armbian/mpads/README.md

## MPADS
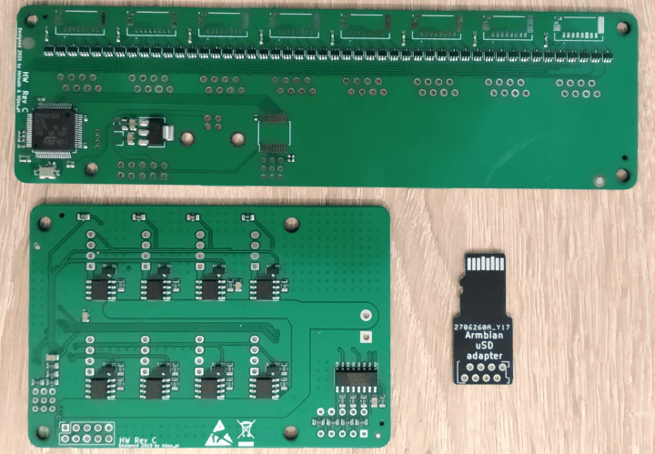
[picture p1: images/mpadsv3.jpg]
Assembled device
<h3 align=center><p><p>Multiple Power And Data Switch</h3>

## Serial MUX board revC
KiCAD 5.99 (new schematic file format)
- decoupling added
- some tweaking of LED control line selection
