armbian/mpads/images/mpads.jpg

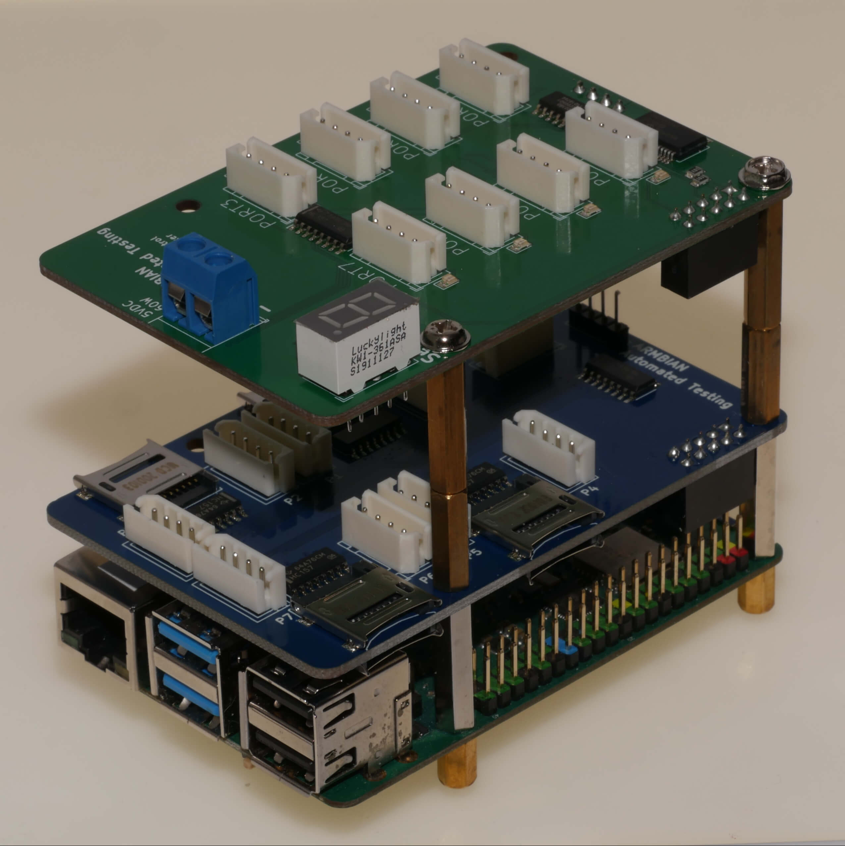
images/mpads.jpg
