armbian/mpads/sd-card-adapter/sd-adapter.png

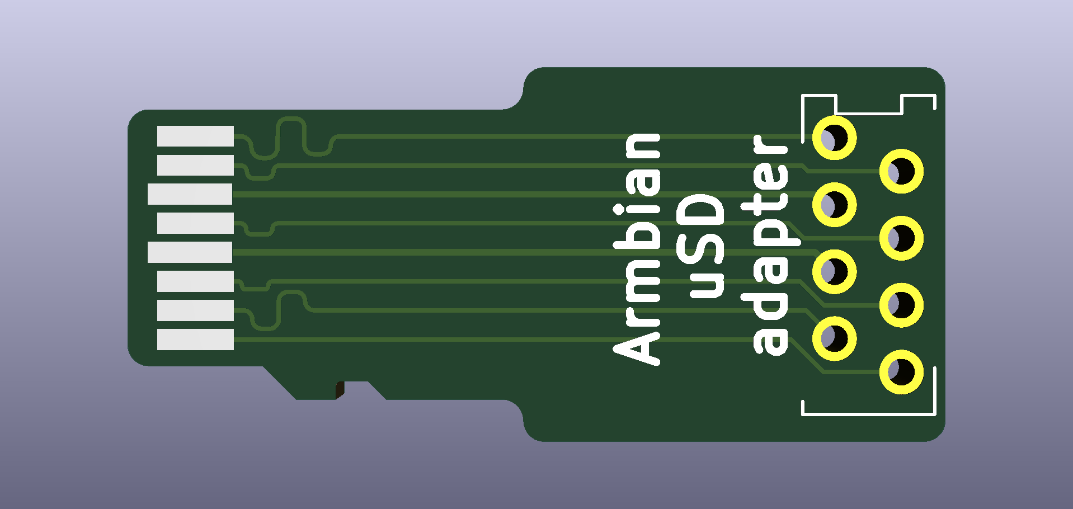
sd-card-adapter/sd-adapter.png
