armbian/mpads/sd-card-mux/ASSEMBLY/sd-card-mux-a.png

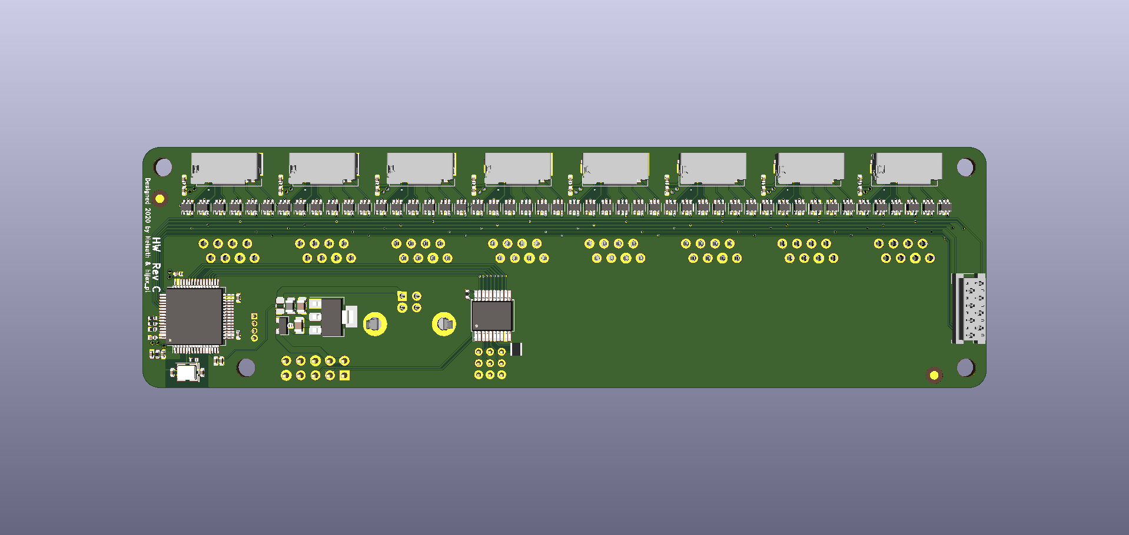
sd-card-mux/ASSEMBLY/sd-card-mux-a.png
