armbian/mpads/sd-card-mux/ASSEMBLY/sd-card-mux-b.png

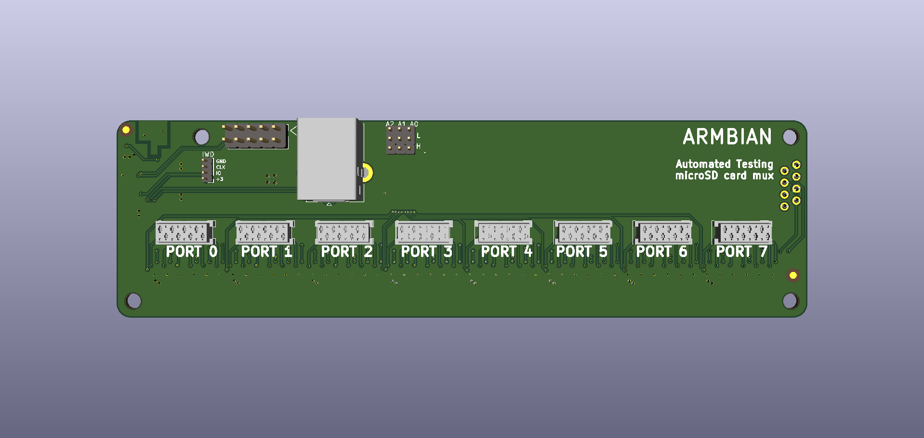
sd-card-mux/ASSEMBLY/sd-card-mux-b.png
