armbian/mpads/sd-card-mux/ASSEMBLY/sd-card-mux.pdf

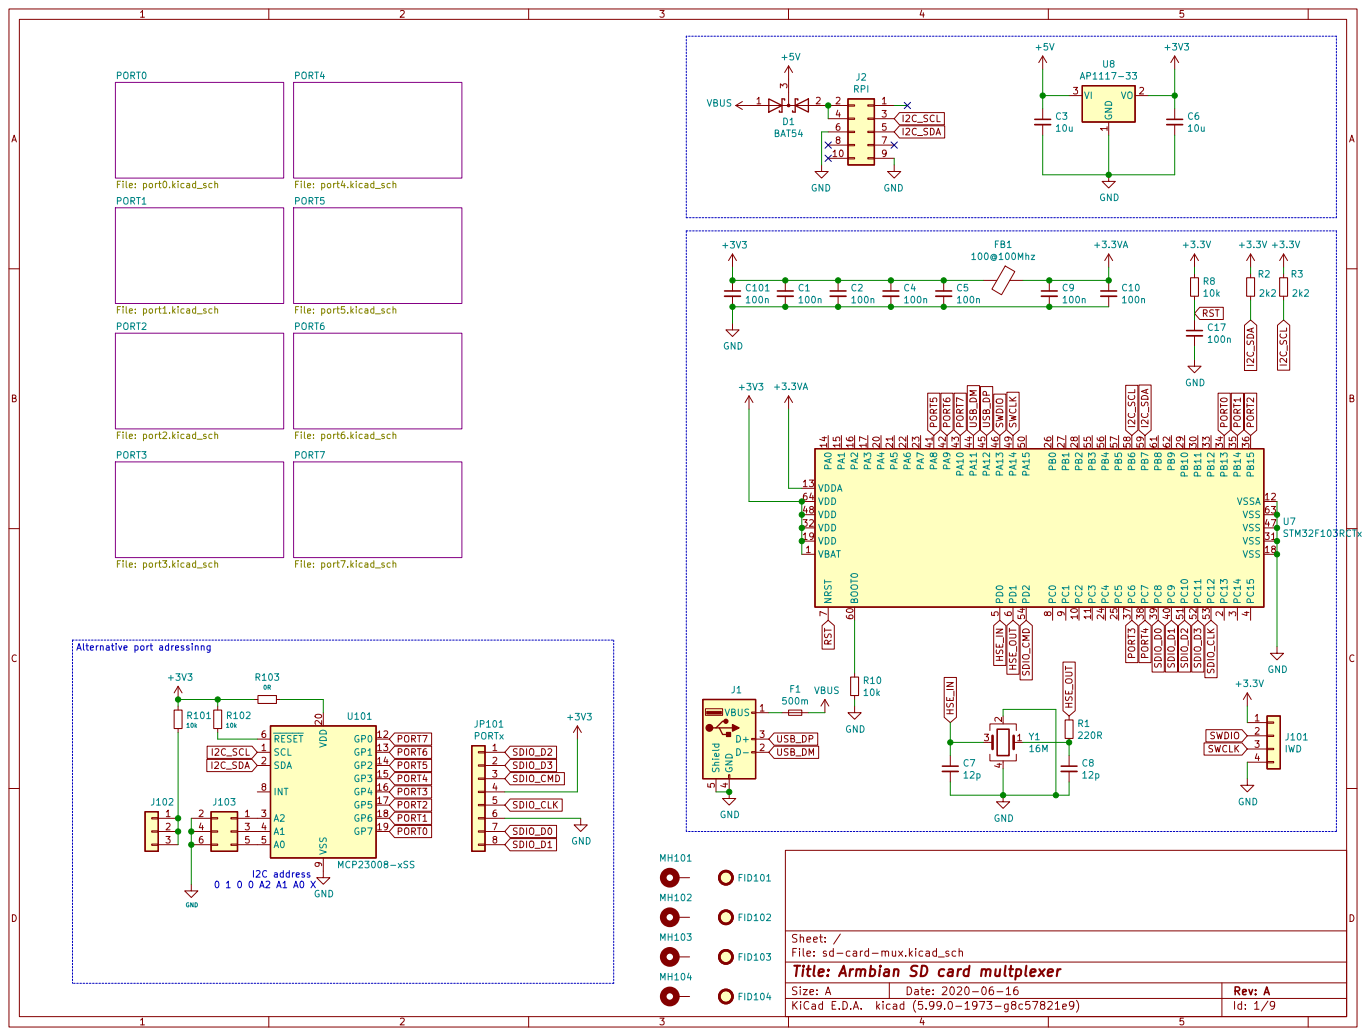
[picture p9: page 1]

6 PD2 54 VBAT 1 VDD 19 VDD 32 VDD 48 VDD 64 VDDA 13 VSS 18 VSS 31 VSS 47 VSS 63 VSSA 12 U7STM32F103RCTx +3V3 +3.3VA

File: sd-card-mux.kicad_sch Sheet: /
Id: 1/9 Title: Armbian SD card multplexer

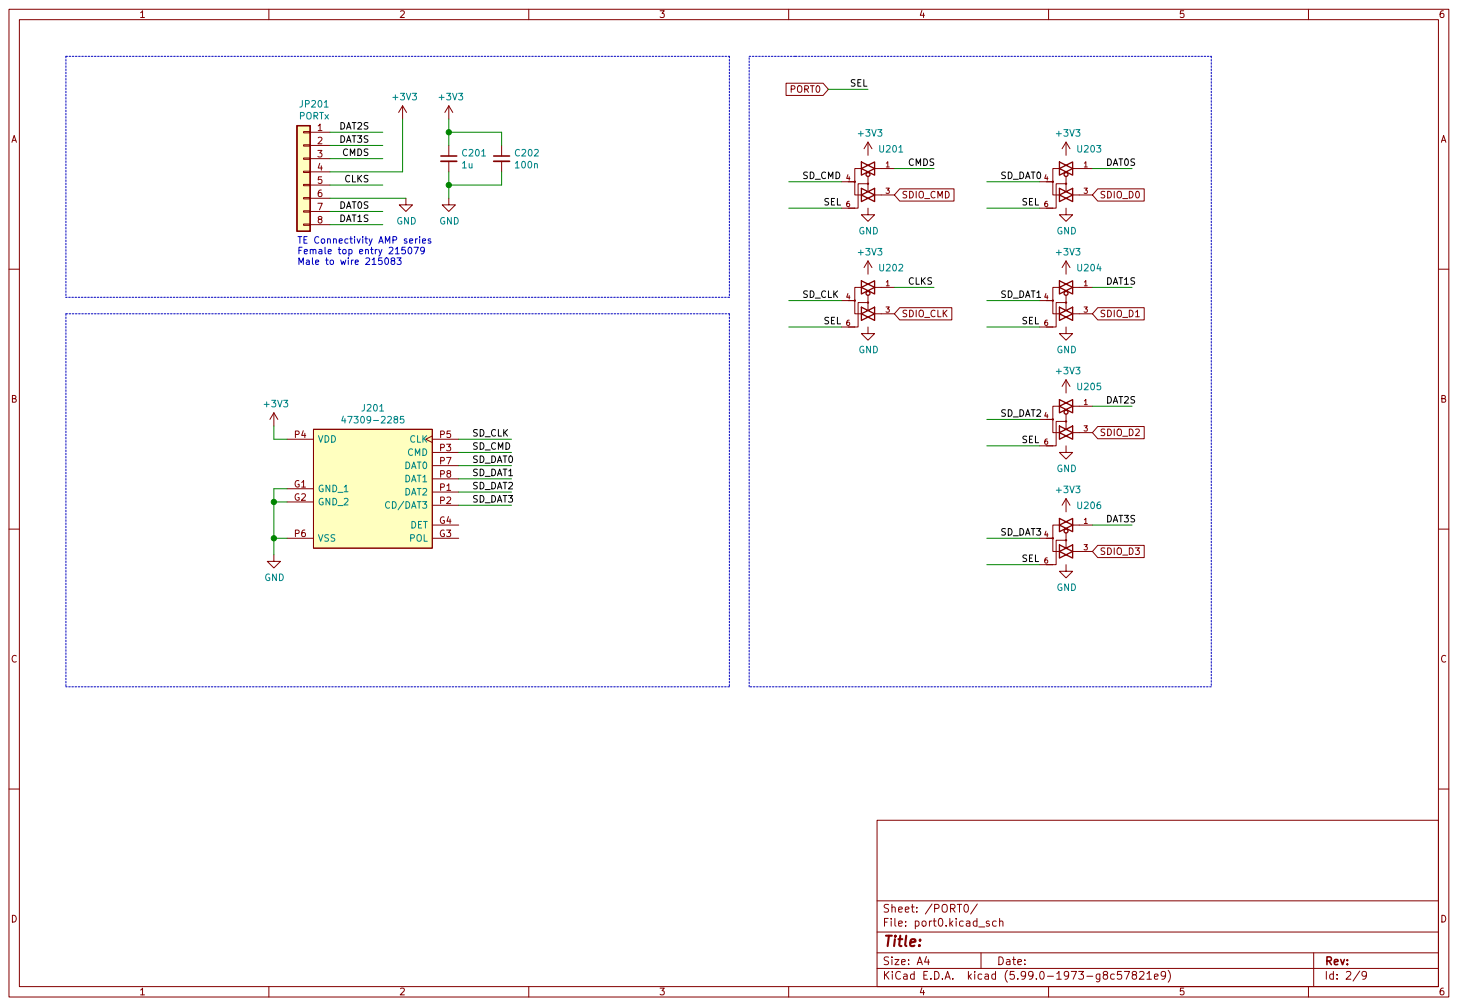
[picture p10: page 2]

TE Connectivity AMP series
Female top entry 215079 Male to wire 215083

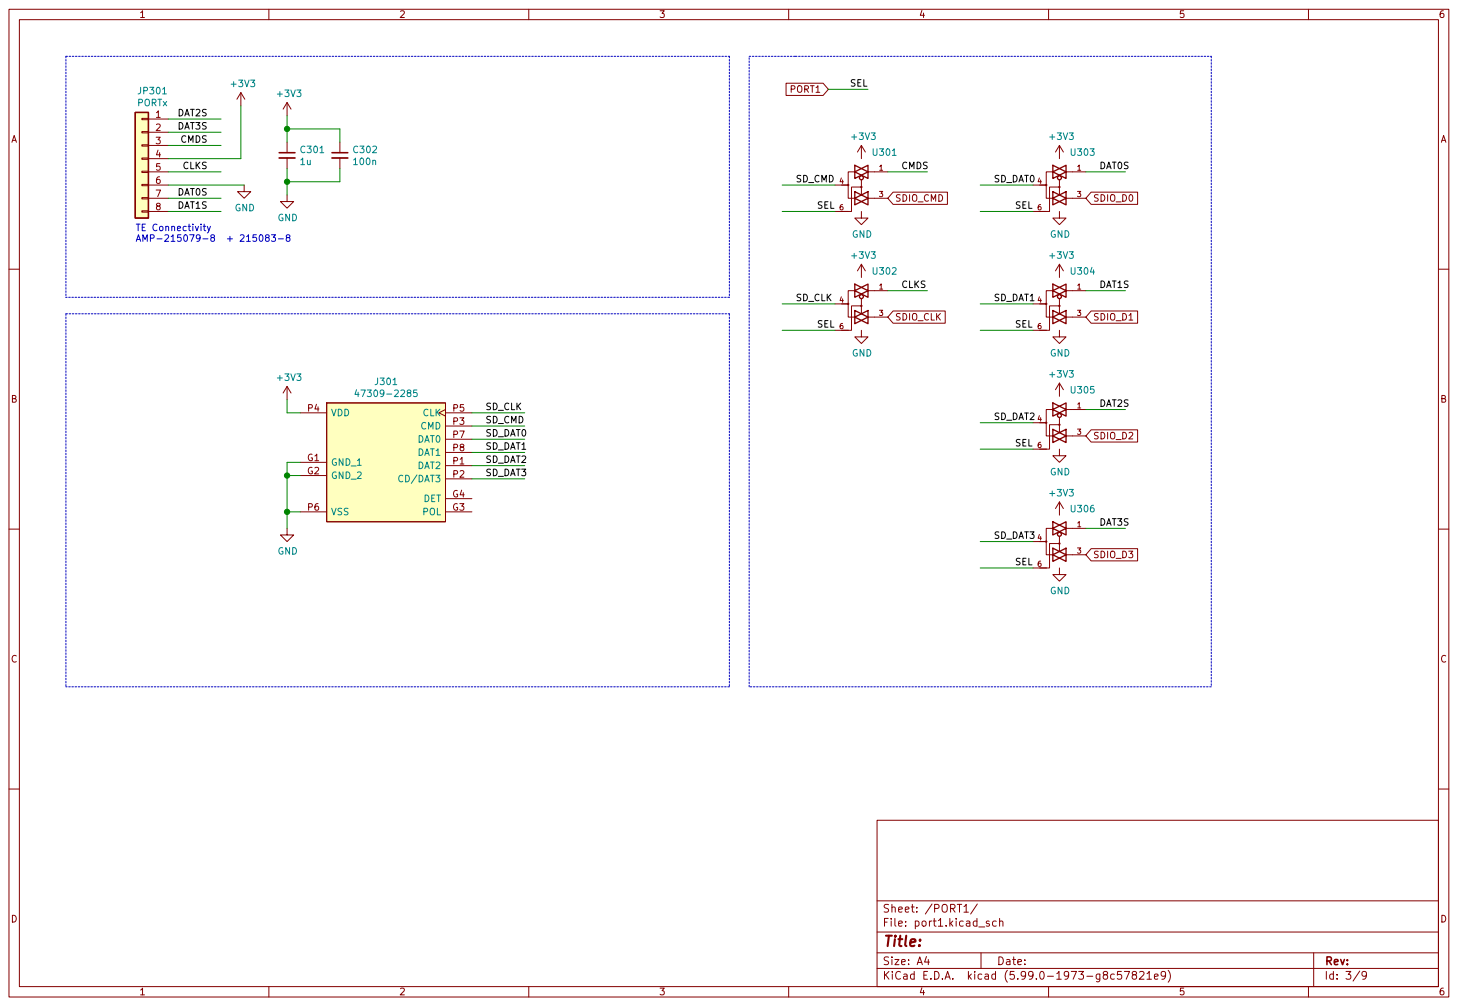
[picture p11: page 3]

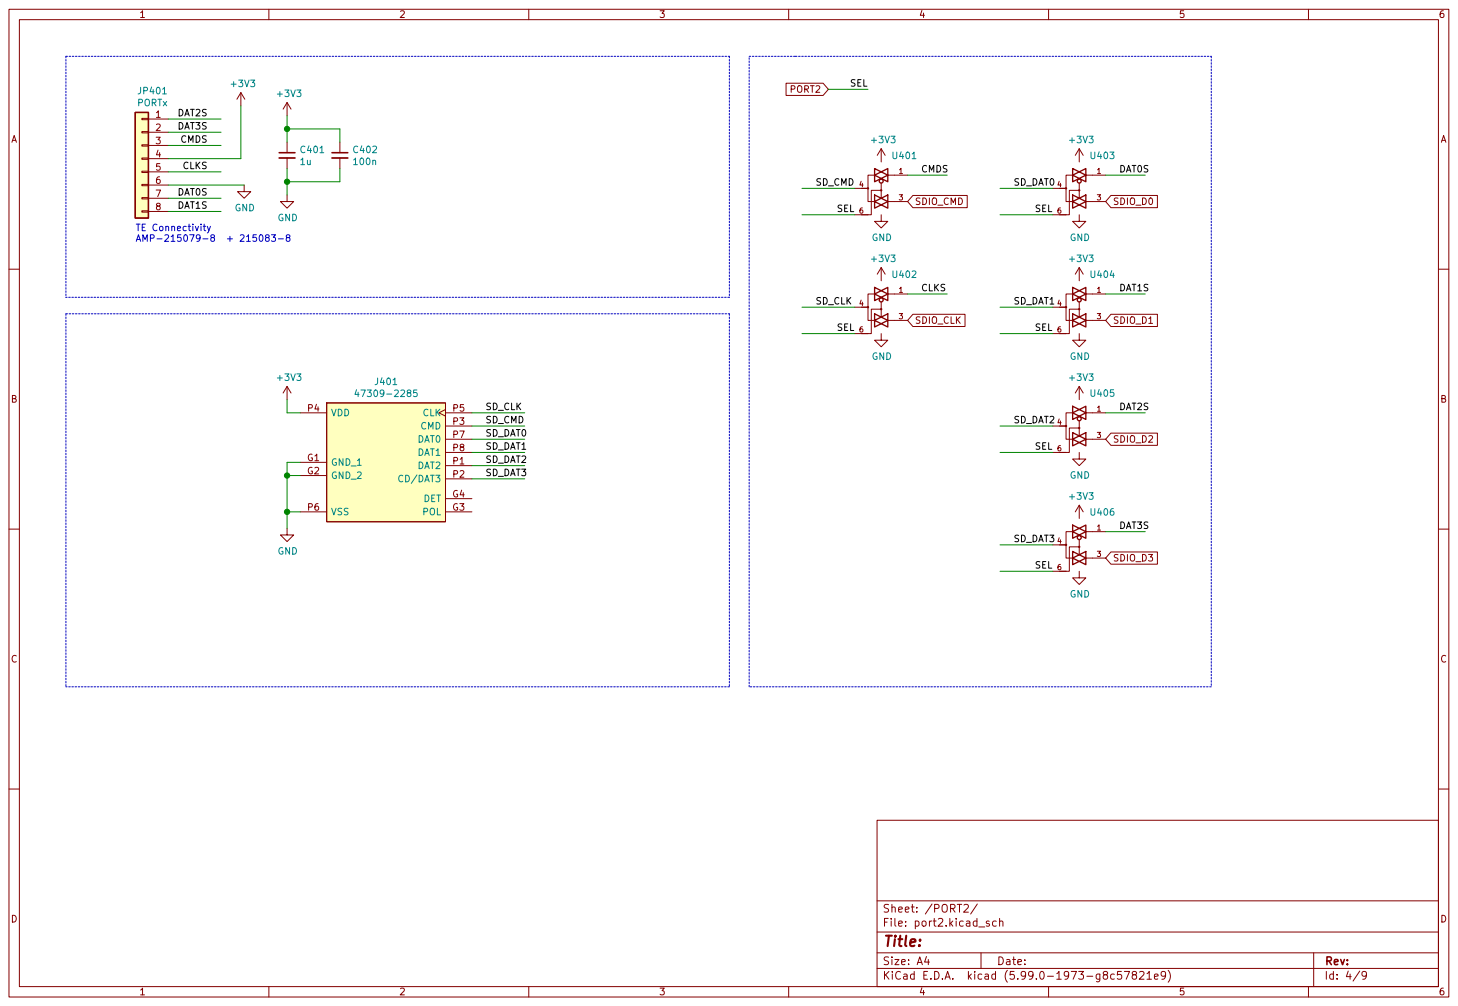
[picture p12: page 4]

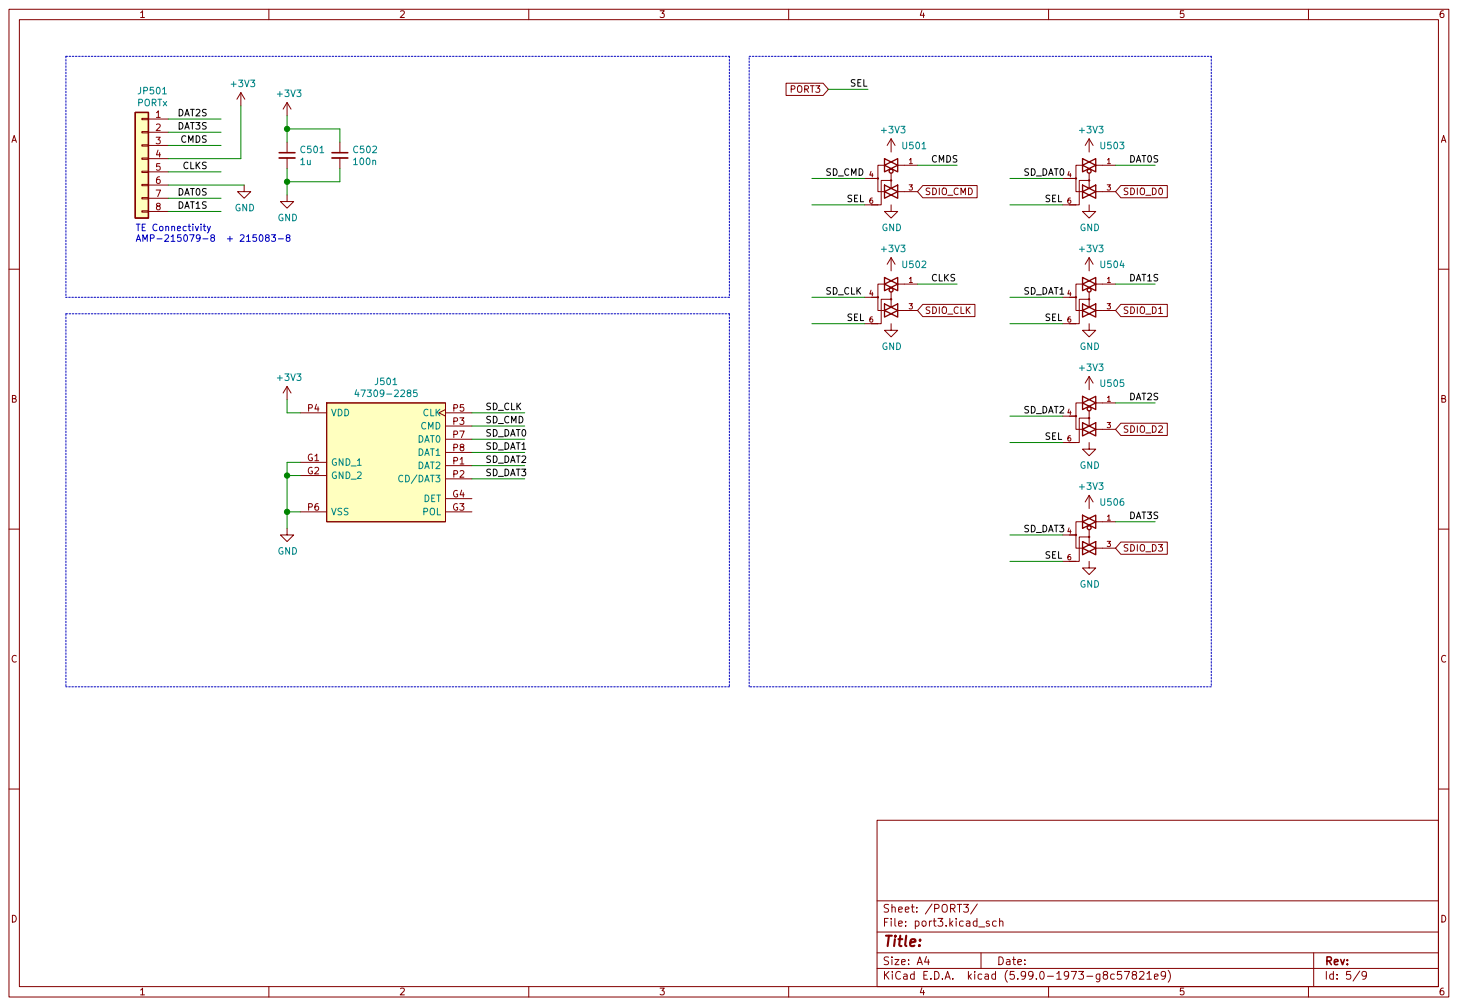
[picture p13: page 5]

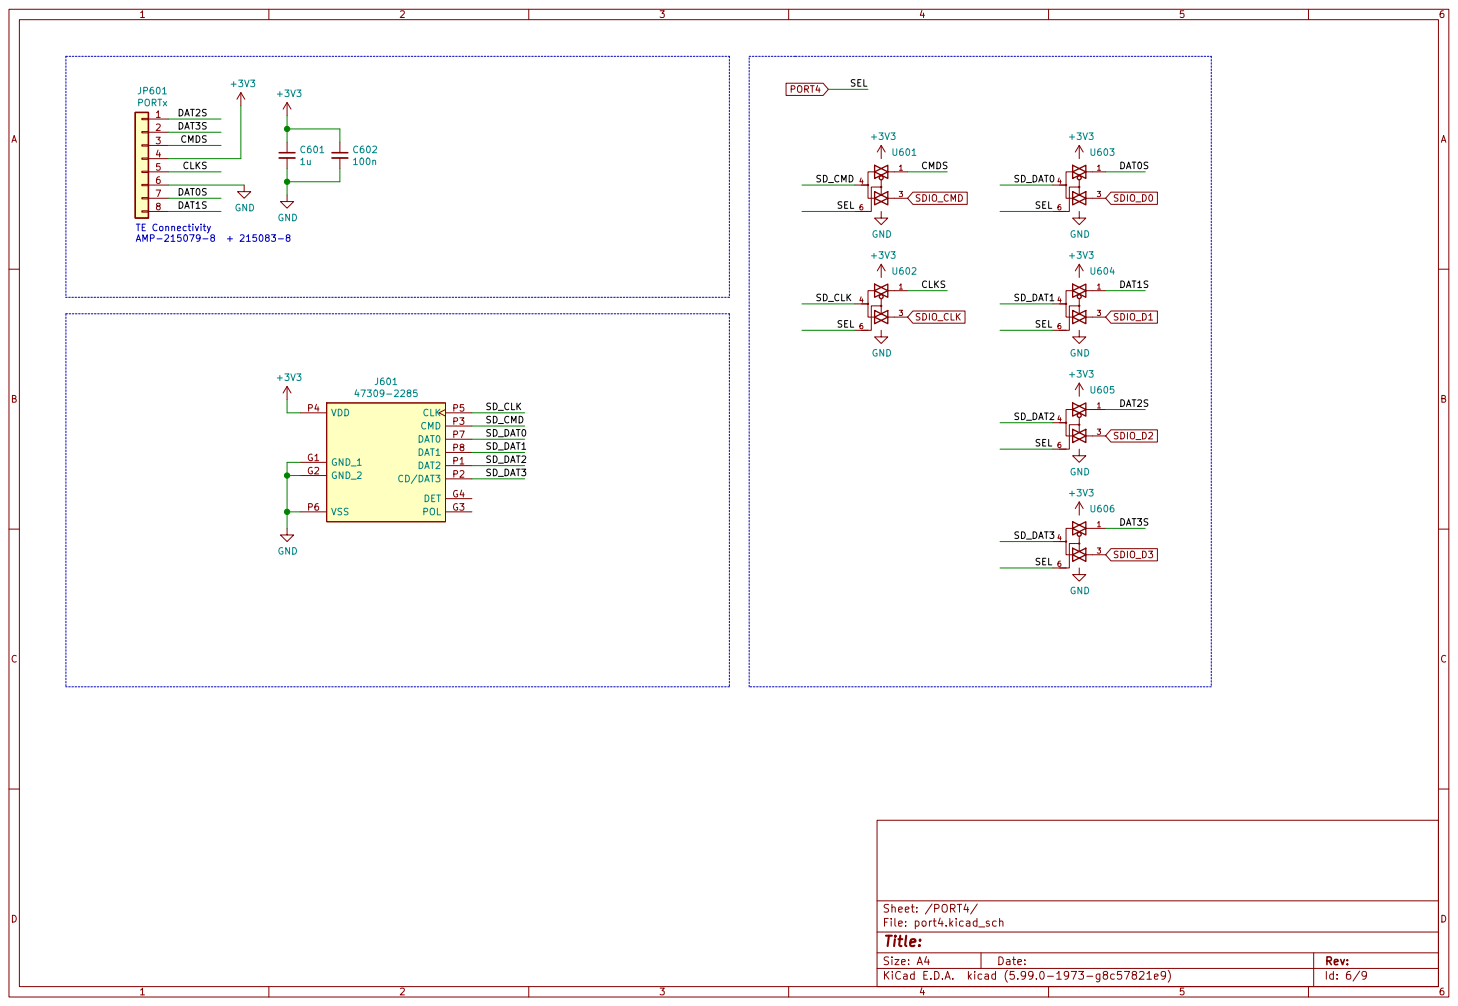
[picture p14: page 6]

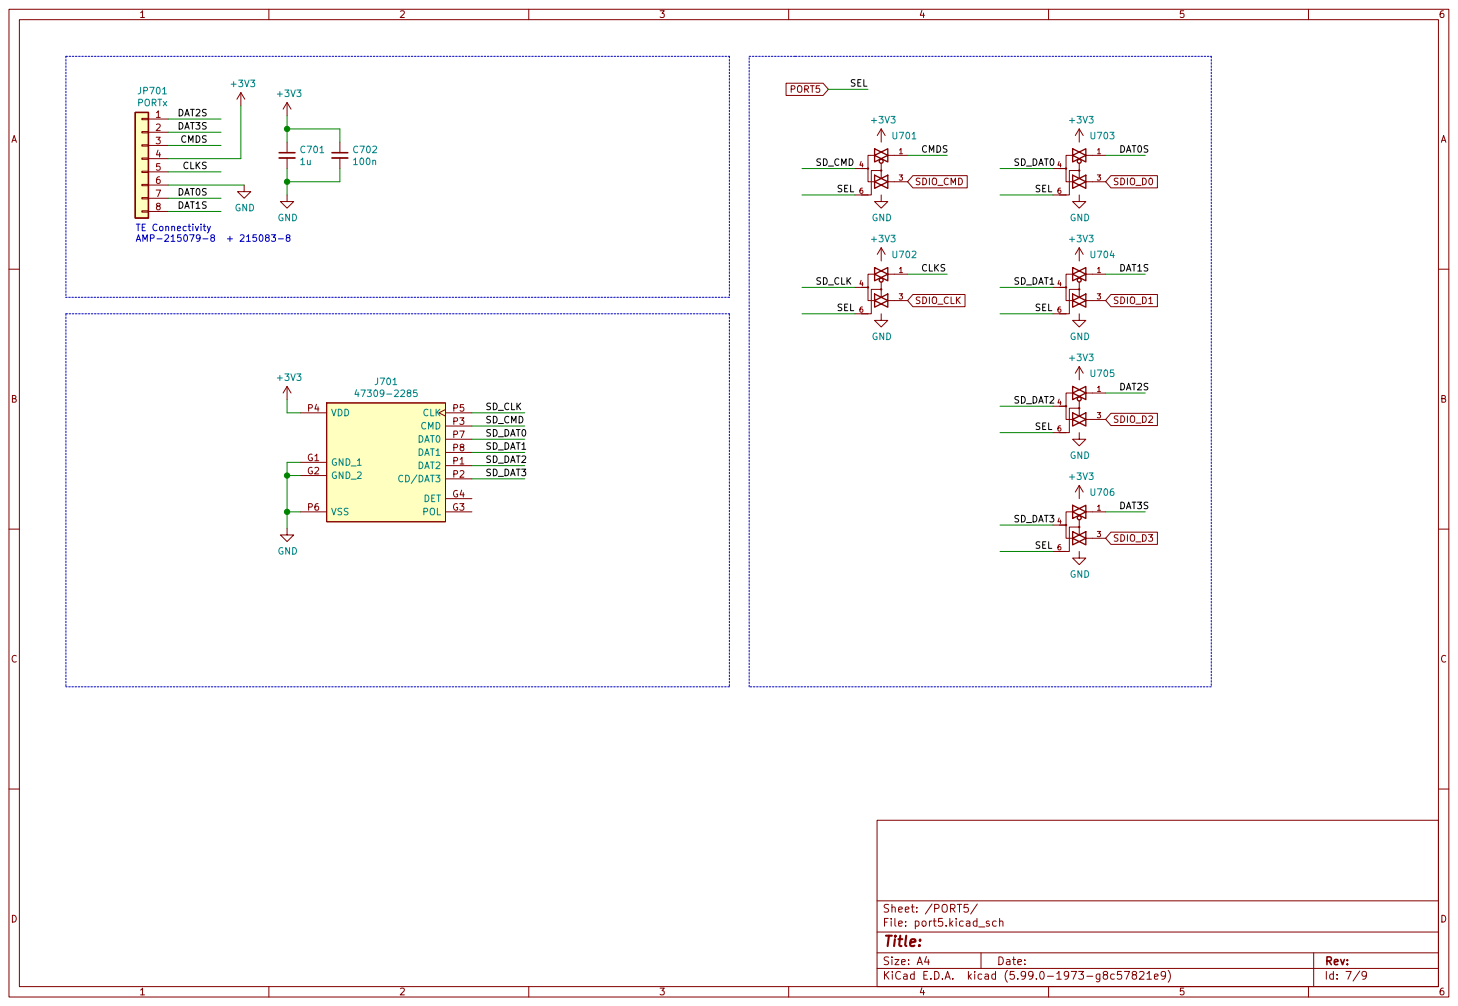
[picture p15: page 7]

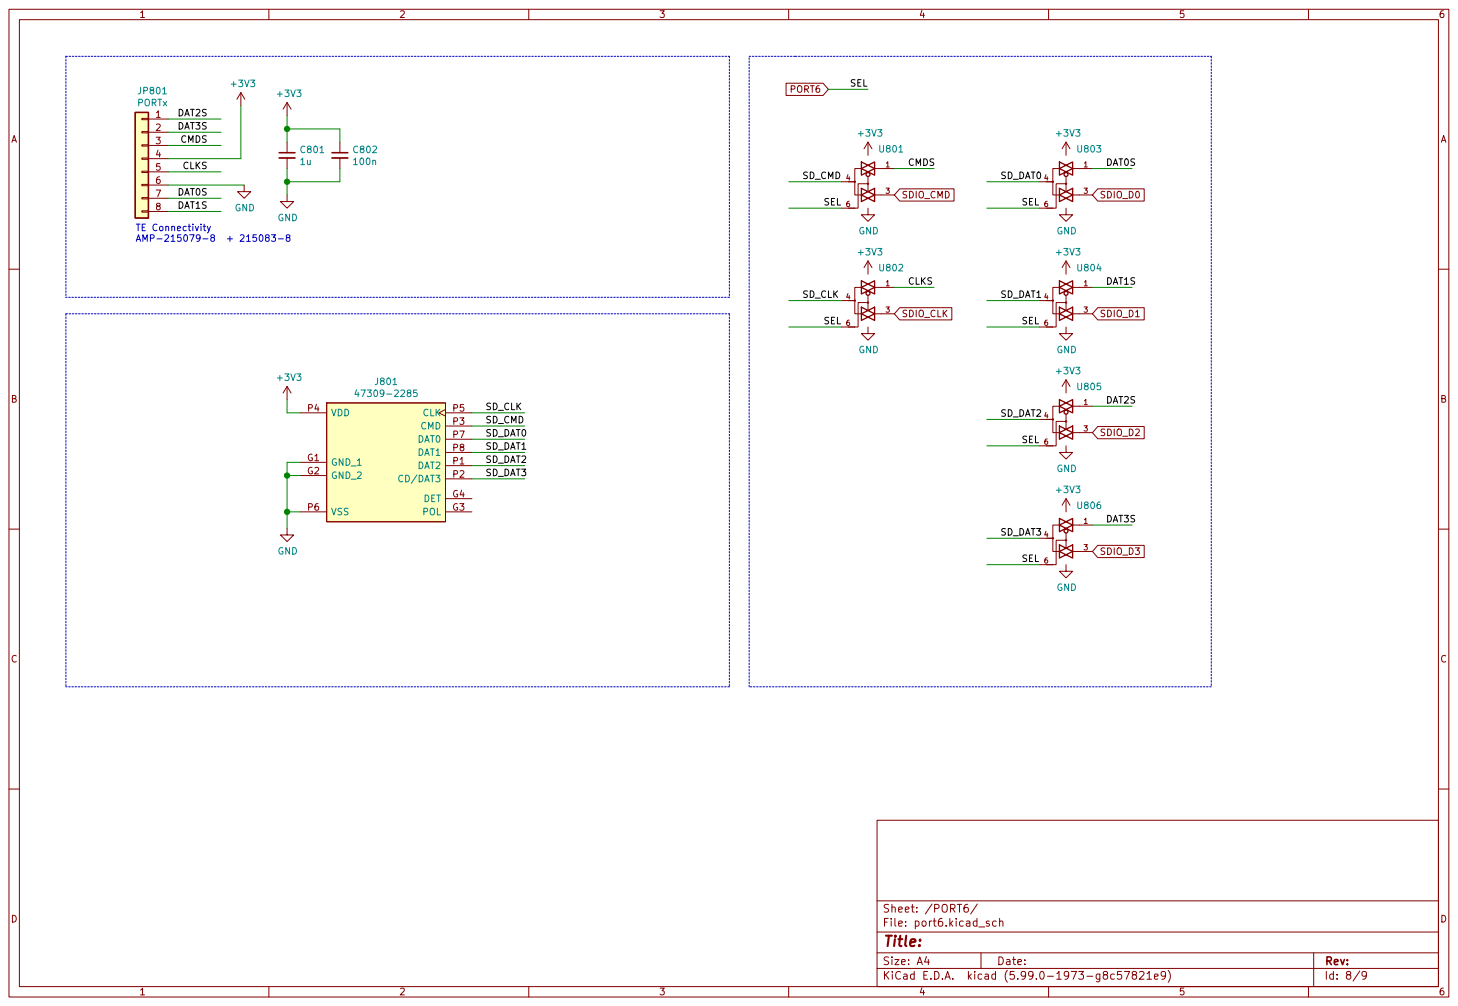
[picture p16: page 8]

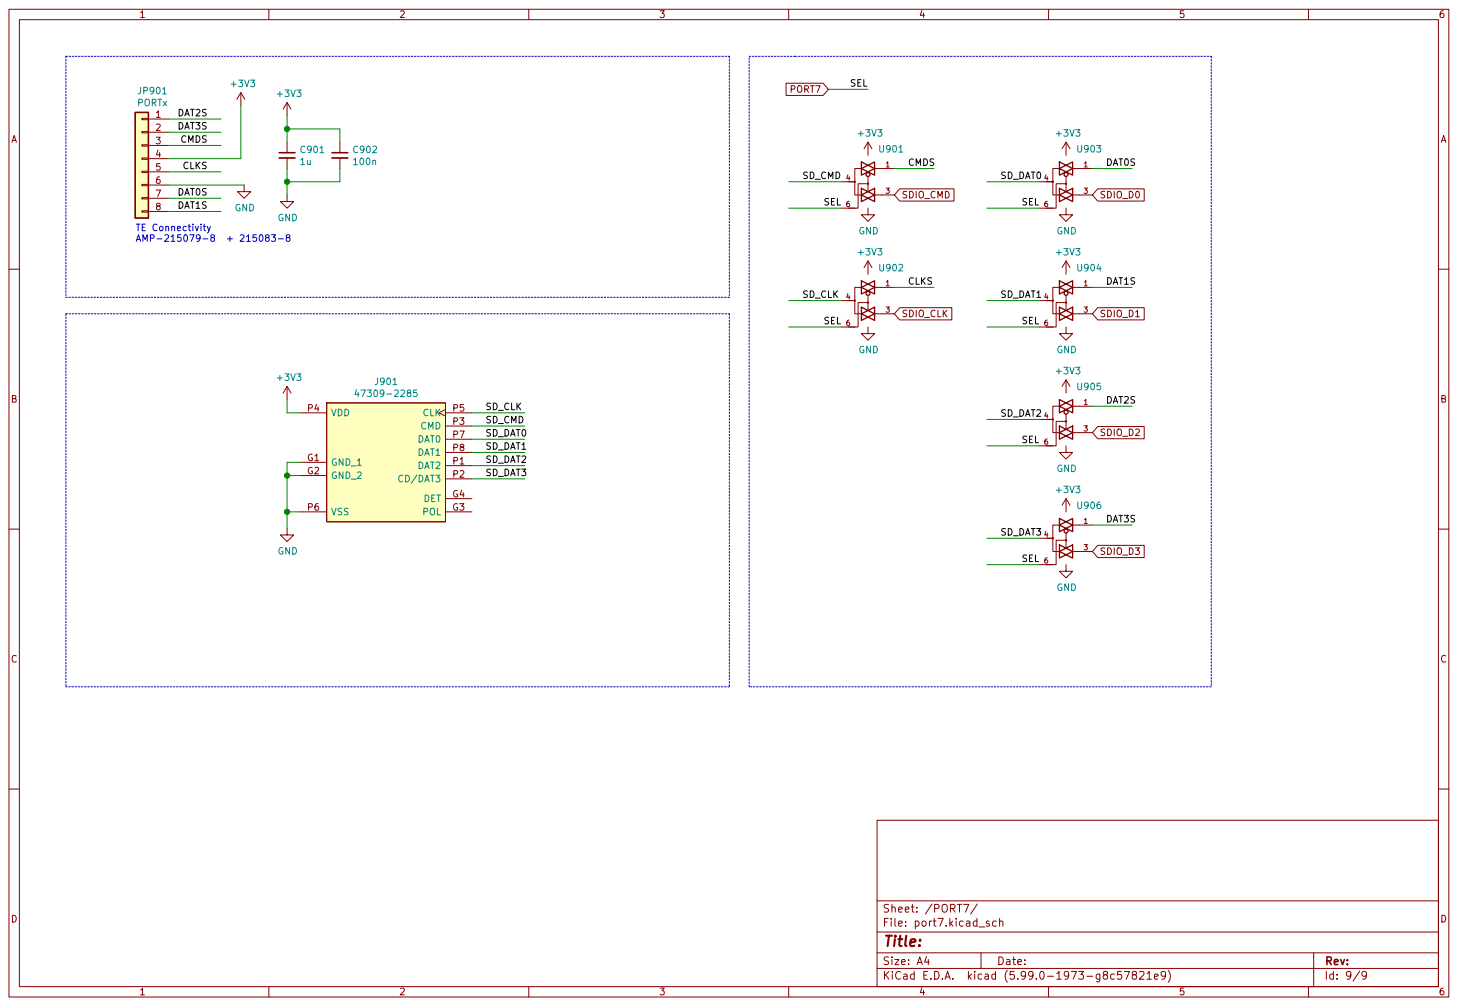
[picture p17: page 9]
