armbian/mpads/serial-mux/assembly/serial-mux.pdf

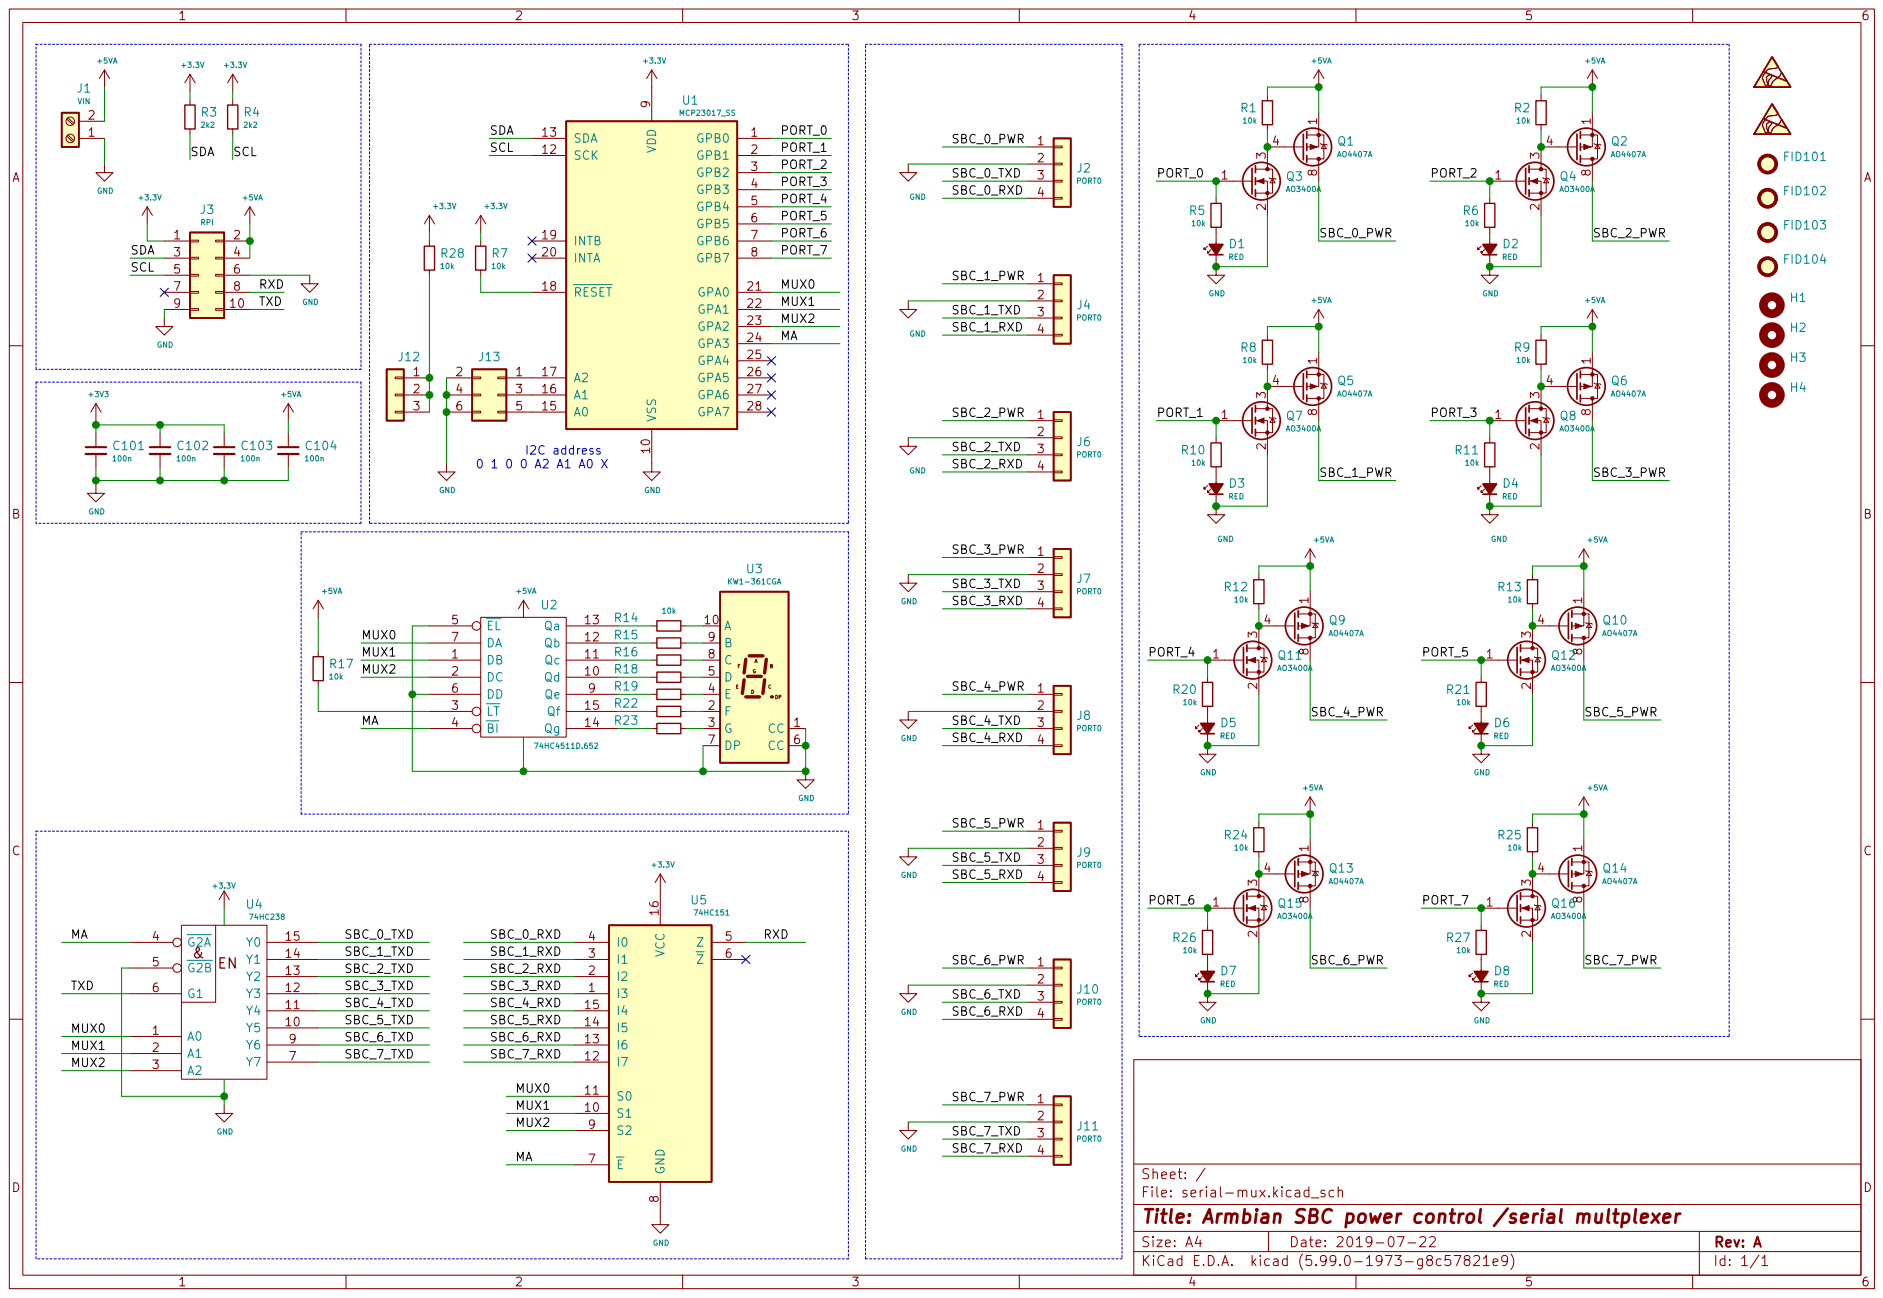
[picture p18: page 1]

File: serial-mux.kicad_sch Sheet: /
Id: 1/1 Title: Armbian SBC power control /serial multplexer
