armbian/mpads/USB2SDIO/Core/Src/main.c

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
/* Includes ------------------------------------------------------------------*/
#include "main.h"
#include "usb_device.h"

I2C_HandleTypeDef hi2c1;

SD_HandleTypeDef hsd;

/* USER CODE BEGIN PV */
int selectedSDcard = 0x15;
/* USER CODE END PV */

void SystemClock_Config(void);
static void MX_GPIO_Init(void);
static void MX_SDIO_SD_Init(void);
static void MX_I2C1_Init(void);
/**
  * @brief  The application entry point.
  * @retval int
  */
int main(void)
{
  /* MCU Configuration--------------------------------------------------------*/

  /* Reset of all peripherals, Initializes the Flash interface and the Systick. */
  HAL_Init();

  /* Configure the system clock */
  SystemClock_Config();

  /* Initialize all configured peripherals */
  MX_GPIO_Init();
  MX_USB_DEVICE_Init();
  MX_SDIO_SD_Init();
  MX_I2C1_Init();
  /* USER CODE BEGIN 2 */

  uint8_t buff[2];
  buff[0] = 255;
  buff[1] = 255;
  /* USER CODE END 2 */

  /* Infinite loop */
  /* USER CODE BEGIN WHILE */
  while (1)
  {
    /* USER CODE END WHILE */

    /* USER CODE BEGIN 3 */
	HAL_StatusTypeDef status = HAL_I2C_Slave_Receive(&hi2c1, buff, 2, 10);
	if (status == HAL_OK)
	{
		if (buff[0] == 0x01 && selectedSDcard != buff[1]) {
			// command to connect/disconnect host to sd
			if (selectedSDcard >= 0 && selectedSDcard < 8) {
				HAL_SD_DeInit(&hsd);
			}


			selectedSDcard = buff[1];

			// disconnect all sd from master, connect to slaves
			HAL_GPIO_WritePin(GPIOB, USB_ENABLE_Pin|PORT0_Pin|PORT1_Pin|PORT2_Pin, GPIO_PIN_RESET);
			HAL_GPIO_WritePin(GPIOC, PORT3_Pin|PORT4_Pin, GPIO_PIN_RESET);
			HAL_GPIO_WritePin(GPIOA, PORT5_Pin|PORT6_Pin|PORT7_Pin, GPIO_PIN_RESET);


			// if valid sd number connect master to this sd
			switch (buff[1]) {
			case 0:
				HAL_GPIO_WritePin(PORT0_GPIO_Port, PORT0_Pin, GPIO_PIN_SET);
				break;
			case 1:
				HAL_GPIO_WritePin(PORT1_GPIO_Port, PORT1_Pin, GPIO_PIN_SET);
				break;
			case 2:
				HAL_GPIO_WritePin(PORT2_GPIO_Port, PORT2_Pin, GPIO_PIN_SET);
				break;
			case 3:
				HAL_GPIO_WritePin(PORT3_GPIO_Port, PORT3_Pin, GPIO_PIN_SET);
				break;
			case 4:
				HAL_GPIO_WritePin(PORT4_GPIO_Port, PORT4_Pin, GPIO_PIN_SET);
				break;
			case 5:
				HAL_GPIO_WritePin(PORT5_GPIO_Port, PORT5_Pin, GPIO_PIN_SET);
				break;
			case 6:
				HAL_GPIO_WritePin(PORT6_GPIO_Port, PORT6_Pin, GPIO_PIN_SET);
				break;
			case 7:
				HAL_GPIO_WritePin(PORT7_GPIO_Port, PORT7_Pin, GPIO_PIN_SET);
				break;
			default:
				break;
			}

			if (selectedSDcard >= 0 && selectedSDcard < 8) {
				MX_SDIO_SD_Init();
				HAL_GPIO_WritePin(USB_ENABLE_GPIO_Port, USB_ENABLE_Pin, GPIO_PIN_SET);
			}

		}
		if (buff[0]==0x02) {
			//command to get currently selected sd card (if any)
//			buff[0] = selectedSDcard;
//			HAL_StatusTypeDef status = HAL_I2C_Slave_Transmit(&hi2c1, buff, 1, 20000);
//			if (status == HAL_OK)
//			{
//				int i = 2;
//			}

		}
	}

  }
  /* USER CODE END 3 */
}

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
