armbian/mpads/USB2SDIO/USB2SDIO.ioc

Mcu.UserName=STM32F103RCTx
PA10.GPIO_Label=PORT7
PA10.Signal=GPIO_Output
PA11.Signal=USB_DM
PA12.Signal=USB_DP
PA13.Signal=SYS_JTMS-SWDIO
PA14.Signal=SYS_JTCK-SWCLK
PA8.GPIO_Label=PORT5
PA8.Signal=GPIO_Output
PA9.GPIO_Label=PORT6
PA9.Signal=GPIO_Output
PB12.GPIO_Label=USB_ENABLE
PB12.Signal=GPIO_Output
PB13.GPIO_Label=PORT0
PB13.Signal=GPIO_Output
PB14.GPIO_Label=PORT1
PB14.Signal=GPIO_Output
PB15.GPIO_Label=PORT2
PB15.Signal=GPIO_Output
PB6.Signal=I2C1_SCL
PB7.Signal=I2C1_SDA
PC10.Signal=SDIO_D2
PC11.Signal=SDIO_D3
PC12.Signal=SDIO_CK
PC6.GPIO_Label=PORT3
PC6.Signal=GPIO_Output
PC7.GPIO_Label=PORT4
PC7.Signal=GPIO_Output
PC8.Signal=SDIO_D0
PC9.Signal=SDIO_D1
PD0-OSC_IN.Signal=RCC_OSC_IN
PD1-OSC_OUT.Signal=RCC_OSC_OUT
PD2.Signal=SDIO_CMD
