armbian/mpads/USB2SDIO/Core/Inc/main.h

#define USB_ENABLE_Pin GPIO_PIN_12
#define USB_ENABLE_GPIO_Port GPIOB
#define PORT0_Pin GPIO_PIN_13
#define PORT0_GPIO_Port GPIOB
#define PORT1_Pin GPIO_PIN_14
#define PORT1_GPIO_Port GPIOB
#define PORT2_Pin GPIO_PIN_15
#define PORT2_GPIO_Port GPIOB
#define PORT3_Pin GPIO_PIN_6
#define PORT3_GPIO_Port GPIOC
#define PORT4_Pin GPIO_PIN_7
#define PORT4_GPIO_Port GPIOC
#define PORT5_Pin GPIO_PIN_8
#define PORT5_GPIO_Port GPIOA
#define PORT6_Pin GPIO_PIN_9
#define PORT6_GPIO_Port GPIOA
#define PORT7_Pin GPIO_PIN_10
#define PORT7_GPIO_Port GPIOA
