armbian/mpads/(commit log)

2020-06-15 SerialMUX initial commit (revC)
    [serial-mux.kicad_pcb, serial-mux.kicad_sch]
2020-06-15 Add initial version of control script
    Add mpads.sh: basic bash script to control the serial mux and sd mux board. Uses i2c-tools to control the registers on the MCP23017
2020-06-15 Added I2C address selection with 2mm jumpers
    [serial-mux.kicad_pcb, serial-mux.kicad_sch]
2020-06-15 Correcting i2c jumpers distance
    [serial-mux.kicad_pcb]
2020-06-15 Adding JLCPCB ordering instruction
    [jlcpcb-bom.csv, serial-mux.kicad_pcb, serial-mux.kicad_sch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]
2020-06-15 Remove unnecesary files
    [serial-mux-bottom-pos.csv, serial-mux-top-pos.csv]
2020-06-16 Update of README for SerialMUX assembly (#2)
    * Update README.md
    * Update README.md
    * Update of the link to ibom.html
2020-07-09 Sd card mux redesign (#3)
    * WIP initial commit
    * Added TQFN for size comparison
    * Added second port with different MUX
    example of MAX4948
    * 74LVC1G3157 & STM32 version
    only 2 SD ports are populated
    * Change to 1.27 ribbon cables
    * Added MCP23008 alternative
    * Small updte of technical layers
    * Removal of board connector
    * Addedd missing upload port
    * Correction of inverted pins
    * Added uSD adapter
    * Small changes
    [port0.kicad_sch, port1.kicad_sch, port2.kicad_sch, port3.kicad_sch, port4.kicad_sch, port5.kicad_sch, port6.kicad_sch, port7.kicad_sch]
2020-12-10 Update usb2sdio, add issues file
    [USB2SDIO.ioc, main.c, main.h]
2021-01-08 Add I2C functions to switch selected sd port
